larryerb/SNEStoCDi/Arduino Nano Adapter Board/images/Board.jpg

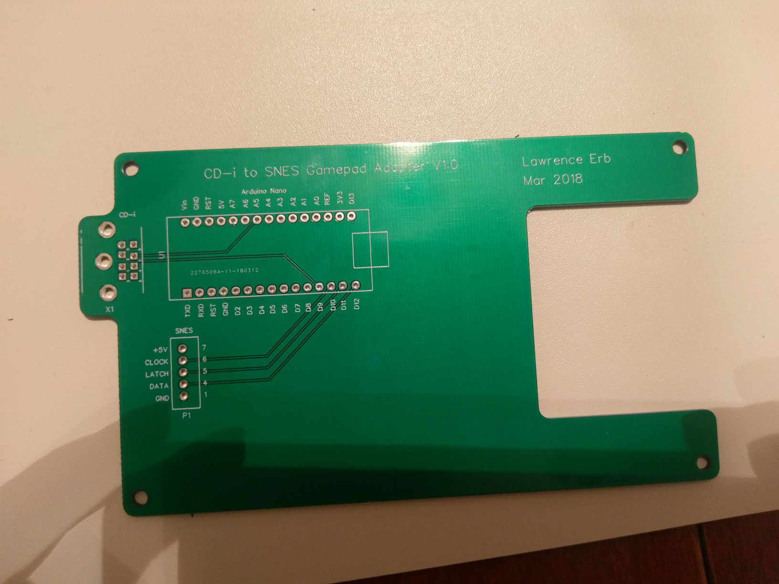
Arduino Nano Adapter Board/images/Board.jpg
