larryerb/SNEStoCDi/Arduino Nano Adapter Board/images/Case_Closed.jpg

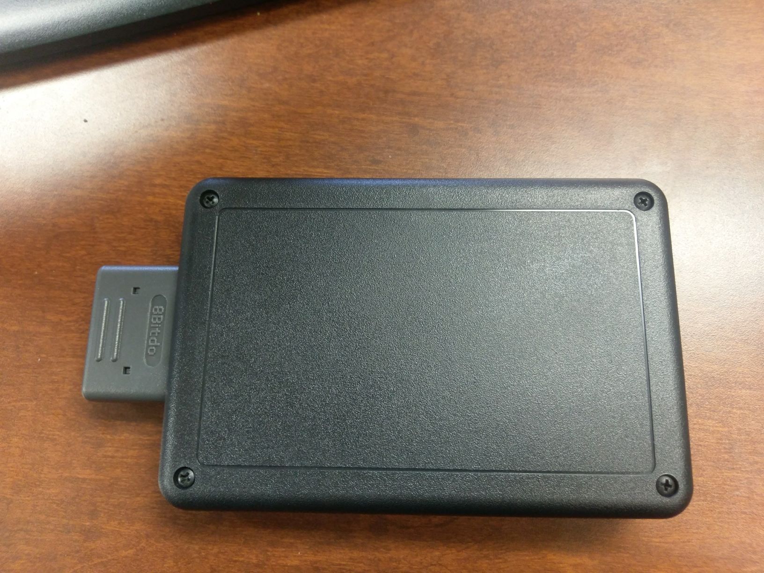
Arduino Nano Adapter Board/images/Case_Closed.jpg
