larryerb/SNEStoCDi/Arduino Nano Adapter Board/Schematic_CD-i SNES_Adapter_Nano.pdf

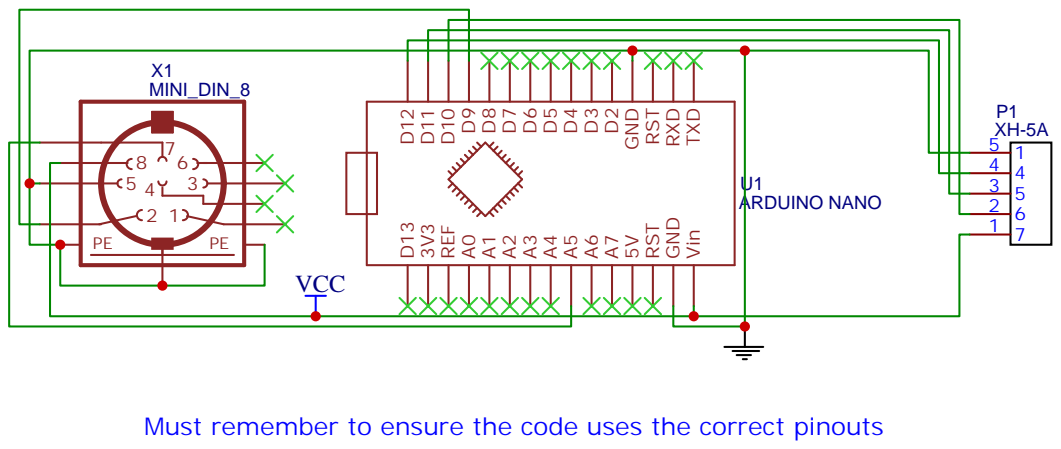
[picture p9: page 1]

Must remember to ensure the code uses the correct pinouts

TITLE:
CD-i SNES Gamepad Adapter
