larryerb/SNEStoCDi/ATtiny85 Adapter Board/Schematic_CD-i_SNES_Adapter_ATtiny85.pdf

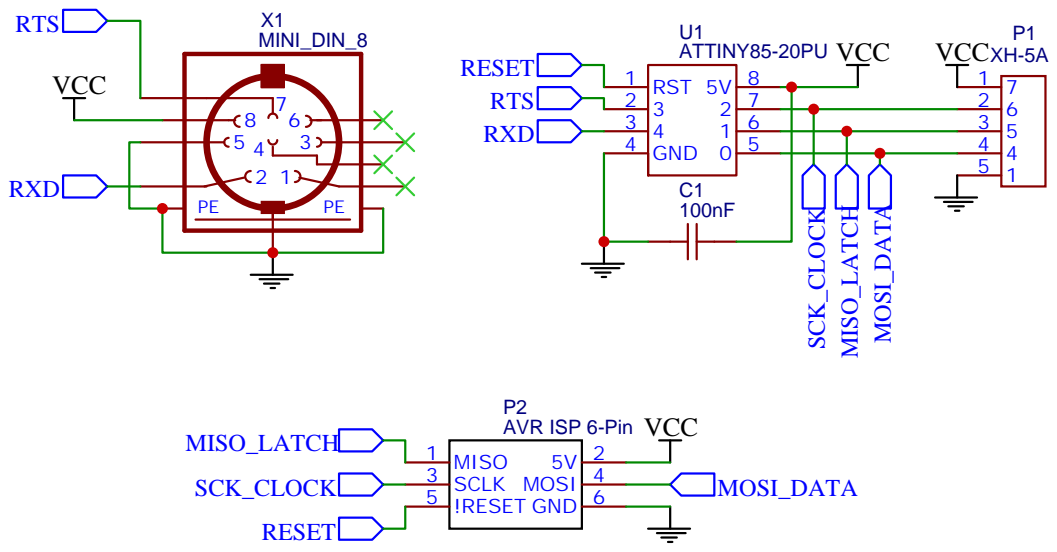
[picture p10: page 1]
