larryerb/SNEStoCDi/(commit log)

2019-08-31 Duplicate arduino code as a starting point
2019-08-31 Switch pins to ATTiny85 pins, remove led pin, and use SendOnlySoftwareSerial rather than Software Serial due to only both having and needing a single pin
2019-08-31 Remove assertRTS() and replace with the analog read itself (moderate performance improvement, 4 function calls per cycle eleminated)
    [sketchSNEStoCDiAtTiny85.ino]
2019-08-31 switch to sane (in my opinion) speed steps
2019-08-31 Minor speed improvement removing 2 function calls per main loop, also add button A as jump in link and zelda games
2019-08-31 Add board schematic and gerber files, and first pass at a readme
2019-08-31 Add board flashing instructions to readme
2019-08-31 Add picture of completed adapter and close up of crimped connector
2019-08-31 Add readme section on code changes from arduino version
2019-08-31 Add Arduino Nano board and rename attiny board folder
2019-08-31 Rename ATtiny gerber and schematic files
2019-08-31 Update Arduino Nano Adapter Board Readme
2019-08-31 Clarify pin changes in readme
2019-08-31 Update main readme to reference the sub folders with the PCB versions of the adapter
